maf70/WoodieLC/images/Screen_Start.jpg

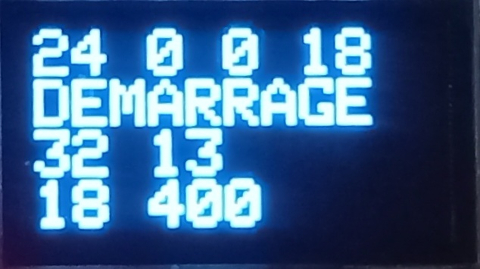
images/Screen_Start.jpg
