maf70/WoodieLC/(threads)

Thread 2 (2025-02-09):

vis temperature error

maf70, 2025-02-09:
Ensure that if vis temperature has occured, it is displayed to user.
