maf70/WoodieLC/(commit log)

2025-01-26 Restart project Commit pending modifs Put all boiler configuration in header file Fix init of MAX6675
    [init.h, moteur.cpp, moteur.h, reglages.h]
2025-01-28 Stop if too many motor blocking
2025-01-29 Add buttons
2025-01-30 Manage button with timer interruption
2025-01-30 Add timer between 2 button press
2025-01-30 Update temperature test threshold
2025-02-02 Set start and stop temperatures Still to do: - Save value in eeprom - add other paraters
2025-02-03 Pilot motor and fan in STOP mode
2025-02-03 Remove Serial usage Avoid an heap/stack pb Strange display in right/low corner
    [WoodieLC.ino, debug.h]
2025-02-04 Add settings: Security temperature: stop if lower, means that no more fire in boiler Security screww: stop if too hot, means that fire begin to go in wood storage Probe select: select the water tempe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
    [WoodieLC.ino, reglages.h]
2025-02-04 Manage 2 temperature probes Detect and manages probe detection error heap/stack pba again
    [WoodieLC.ino, init.h, reglages.h]
2025-02-05 Check security temperatures Manage error security state Add START mode of boiler to allow restart
    [WoodieLC.ino, reglages.h]
2025-02-06 Ass start motor in reverse in stop mode
    [WoodieLC.ino, moteur.cpp, moteur.h]
2025-02-09 Add secu state for boiler Avoid to restart motor or fan if security pb
    [WoodieLC.ino, reglages.h]
2025-02-09 Display ERREUR title in secu boiler state Also stop motor and fan
